Sternenlabor/Blinkenstar/firmware/README.md

When you flash the Blinkenstar make sure to set the FUSES.
See flash.sh for the full command.
