Sternenlabor/Blinkenstar/hardware/Blinkenstar/Blinkenstar-back.png

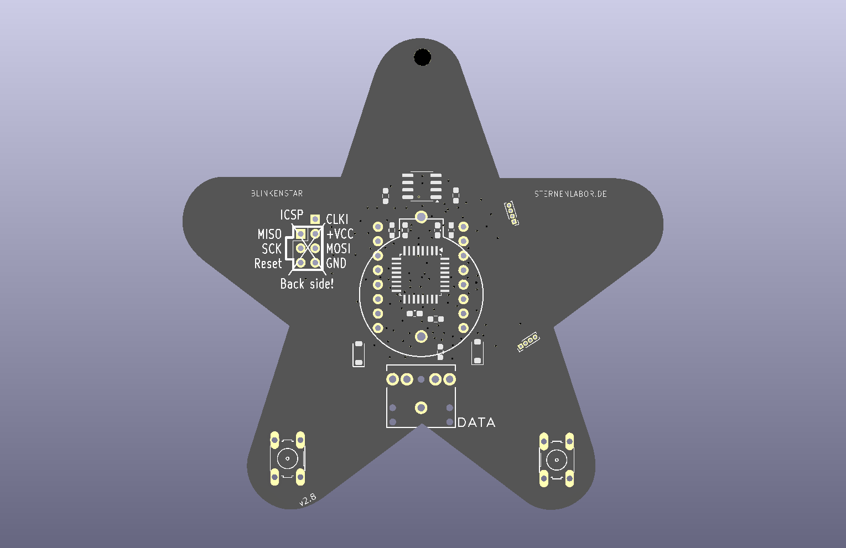
hardware/Blinkenstar/Blinkenstar-back.png
