Sternenlabor/Blinkenstar/hardware/Blinkenstar/Blinkenstar-front.png

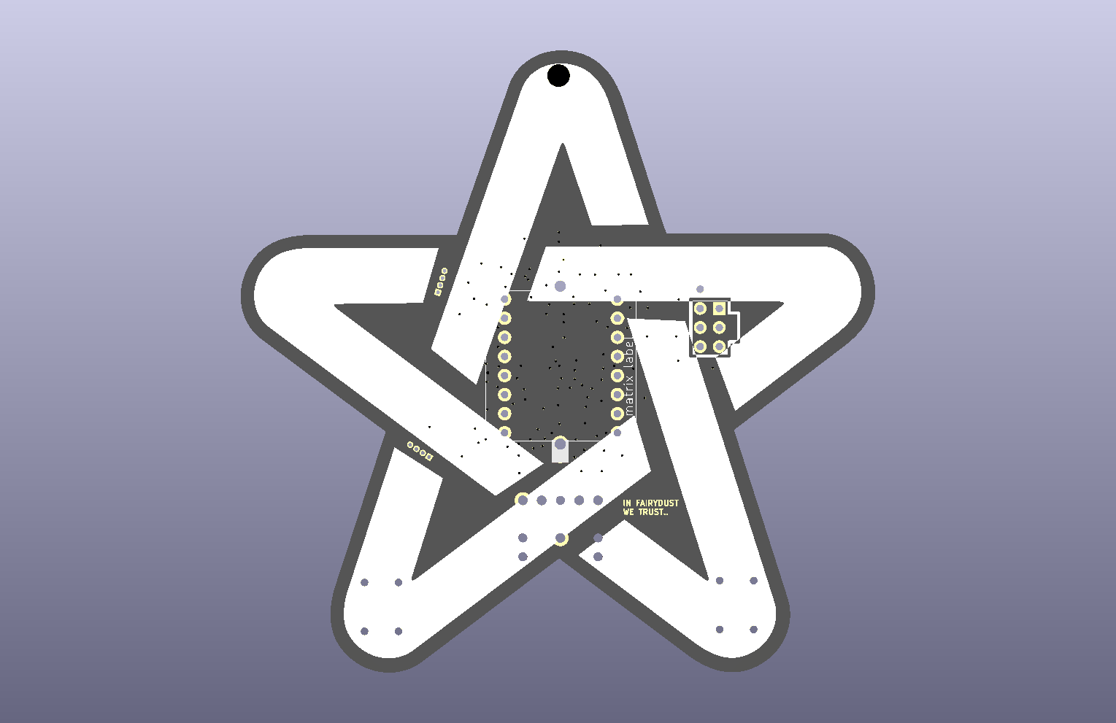
hardware/Blinkenstar/Blinkenstar-front.png
