Sternenlabor/Blinkenstar/hardware/Blinkenstar/parts/TEPT5700.step

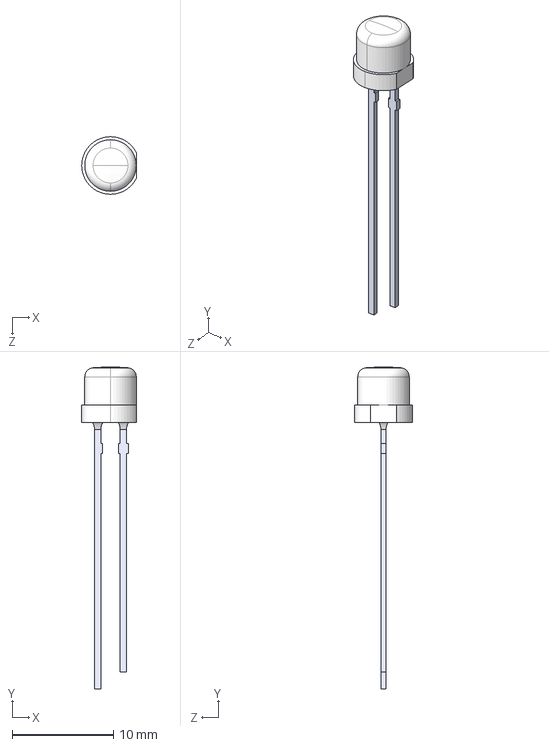
[picture p6: CAD file, 2025-06-20]
hardware/Blinkenstar/parts/TEPT5700.step
5.40 x 31.9 x 5.70 mm
