Sternenlabor/Blinkenstar/hardware/Blinkenstar/parts/B3F-1000.step

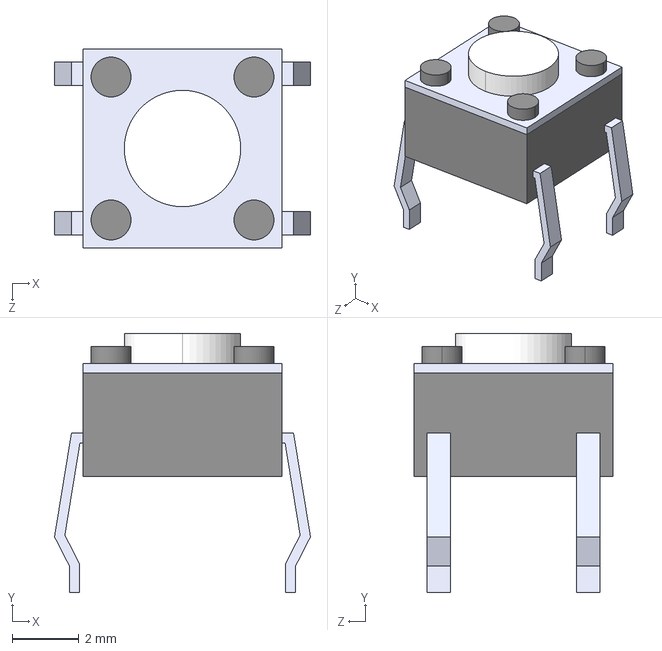
[picture p7: CAD file, 2025-06-01]
hardware/Blinkenstar/parts/B3F-1000.step
7.70 x 7.80 x 6.00 mm
