Sternenlabor/Blinkenstar/hardware/Blinkenstar/parts/M24C64-RMN6TP.STEP

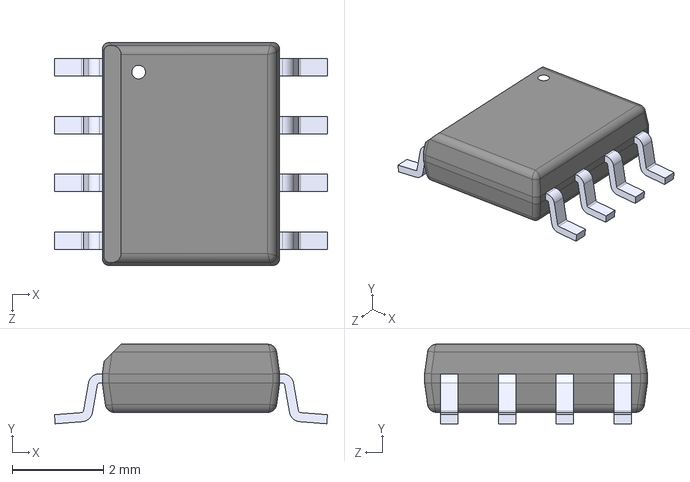
[picture p9: CAD file, 2025-03-28]
hardware/Blinkenstar/parts/M24C64-RMN6TP.STEP
6.00 x 1.75 x 4.90 mm
