Sternenlabor/Blinkenstar/hardware/Blinkenstar/parts/PJ-307--3DModel-STEP-510211.STEP

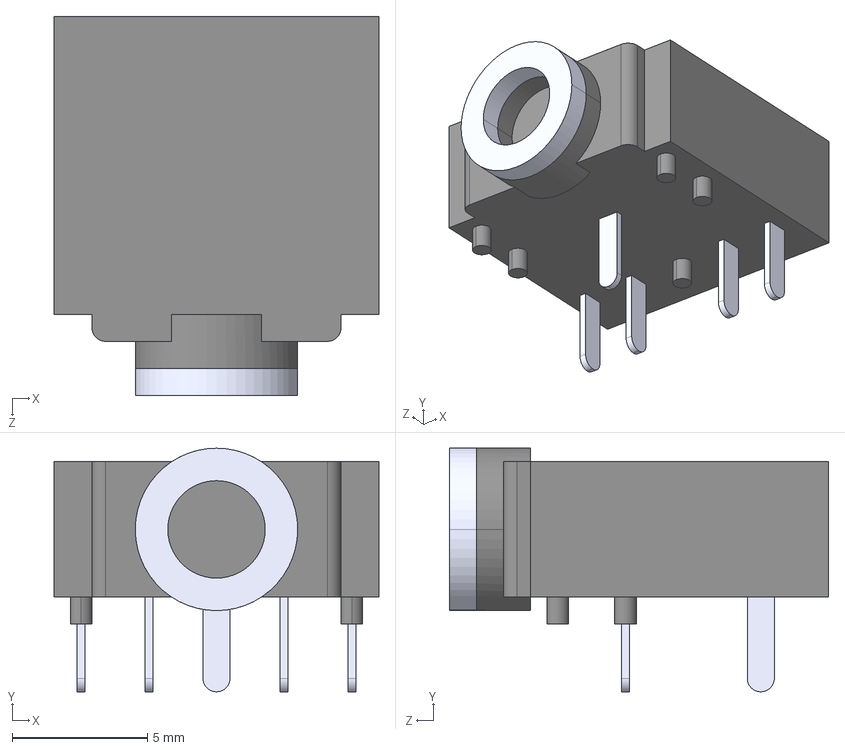
[picture p10: CAD file, 2025-03-28]
hardware/Blinkenstar/parts/PJ-307--3DModel-STEP-510211.STEP
12.0 x 9.00 x 14.0 mm
