Sternenlabor/Blinkenstar/hardware/Blinkenstar/parts/ATTINY88-AU.STEP

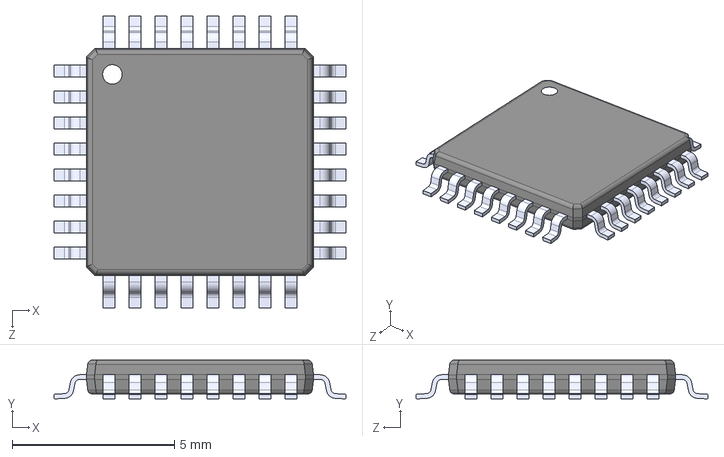
[picture p11: CAD file, 2025-03-28]
hardware/Blinkenstar/parts/ATTINY88-AU.STEP
9.00 x 1.20 x 9.00 mm
