Sternenlabor/Blinkenstar/hardware/Blinkenstar/parts/TA08-81GWA--3DModel-STEP-510211.STEP

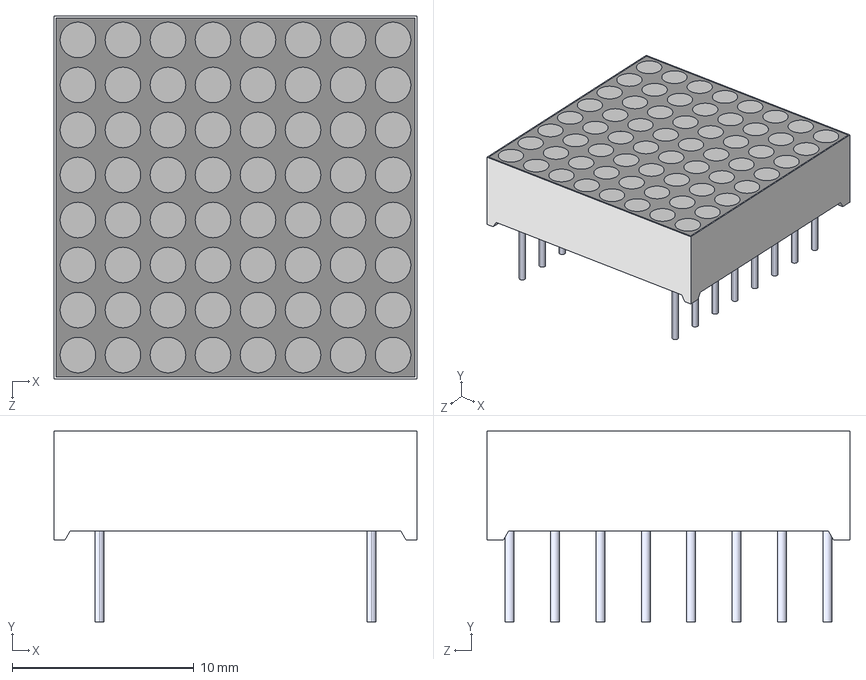
[picture p12: CAD file, 2025-03-28]
hardware/Blinkenstar/parts/TA08-81GWA--3DModel-STEP-510211.STEP
20.0 x 10.5 x 20.0 mm
