Sternenlabor/Blinkenstar/manual/manual.generated.pdf

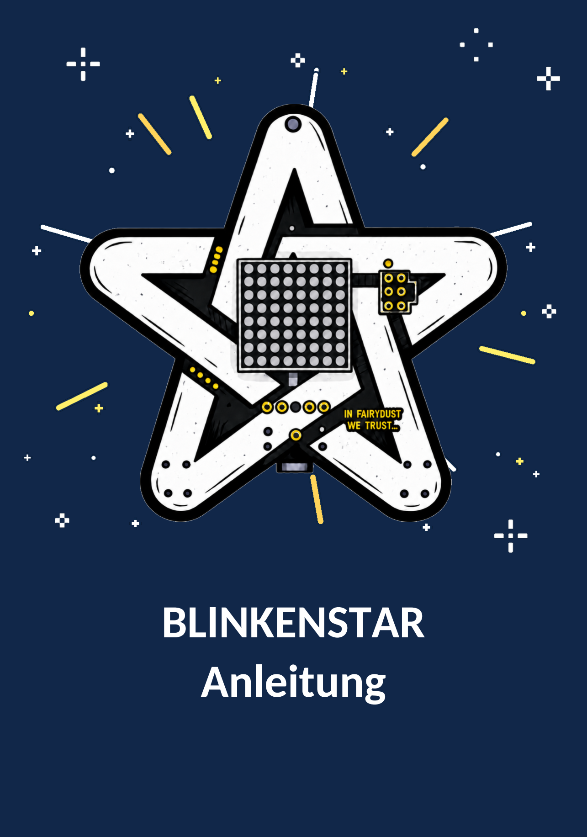
[picture p13: page 1]

# BLINKENSTAR Anleitung

## SICHERHEITSHINWEISE

Nach dem Löten musst du dir deine Hände gründlich mit Seife waschen. Lötzinn ist nicht gesund und sollte nicht in die Nähe von Essen kommen. Essen und Trinken solltest du beim Löten vermeiden!

## LÖTEN LERNEN

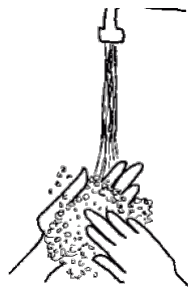
[picture p14: figure]

Zum Löten benötigst du einen Lötkolben, der auf eine Temperatur zwischen 310°C und 350°C eingestellt werden muss. Bei dieser Temperatur wird das Lötzinn flüssig und verbindet dein Bauteil mit der Platine. Bei so viel Hitze kannst du dich und andere schnell verletzen. Stelle deswegen den Lötkolben immer in die Halterung, wenn du ihn gerade nicht benötigst.

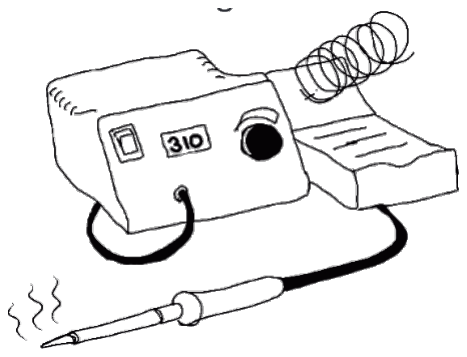
[picture p15: figure]

## BEDRAHTETE BAUTEILE LÖTEN

Stecke das Bauteil an der passenden Stelle durch die Löcher in der Platine. Das Bauteil muss auf der bedruckten Seite aufliegen. Sollte das Bauteil rausfallen, biege die Beinchen leicht zur Seite. Nun lötest du nacheinander die Beinchen des Bauteils. Heize dazu gleichzeitig das Beinchen des Bauteils und die Platine auf. Führe dann seitlich etwas Lötzinn hinzu, bis sich ein kleiner Hügel Lötzinn bildet, der das Loch vollständig bedeckt.

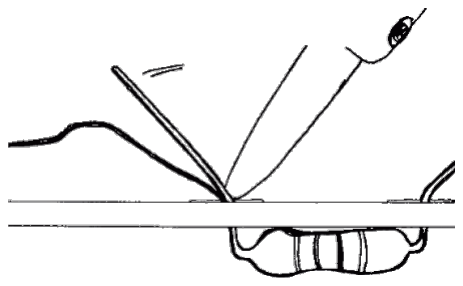
[picture p16: figure]

Die Lötstelle sollte ungefähr wie auf dem folgenden Bild aussehen. Überflüssiges Lötzinn kannst du mit der Lötspitze an dem Draht- beinchen nach oben ziehen. Mit etwas Übung werden deine Lötstellen immer besser!

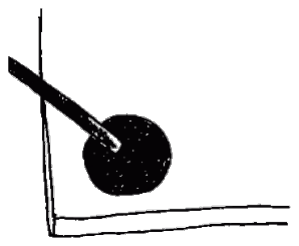
[picture p17: figure]
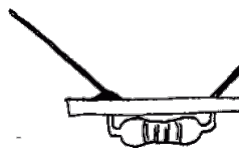
[picture p18: figure]

## SMD BAUTEILE LÖTEN

SMD Bauteile sind Bauteile, die du auf der Oberfläche der Platine an so genannte "Lötpads" anlötest. Lötpads sind Flächen auf der Platine, die Lötzinn annehmen. Um ein SMD Bauteil anzulöten, erhitzt du die Platine zunächst an den quadratischen oder rechteckigen Flächen, die wir "Pad" nennen. Gib auf eine Seite eines Pad-Paares etwas Lötzinn bis sich ein kleiner Berg Lötzinn gebildet hat. Es ist wichtig, dass immer nur ein Pad mit Lötzinn bedeckt wird, sonst wird das Löten sehr schwierig!

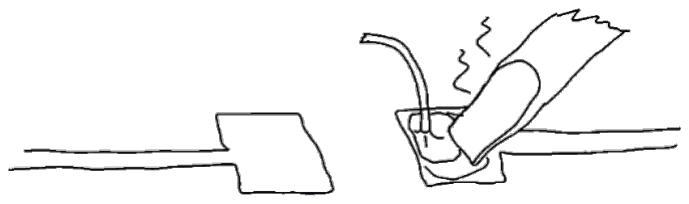
[picture p19: figure]

Halte nun den Lötkolben an das mit Lot bedeckte Pad und greife das Bauteil gleichzeitig mit einer Pinzette. Schiebe das Bauteil mit einer Seite in das flüssige Lot, so dass es mittig zwischen den beiden Pads sitzt. Entferne nun den Lötkolben und halte das Bauteil solange fest, bis das Lötzinn wieder fest geworden ist.

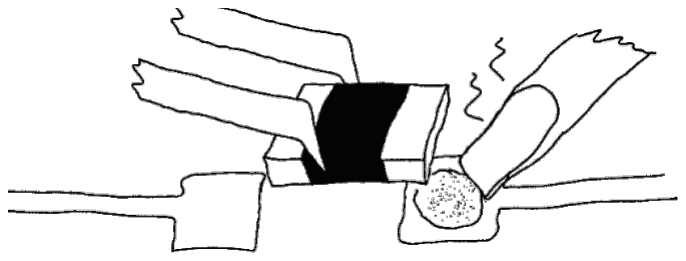
[picture p20: figure]

Um die andere Seite des Bauteils festzulöten, erhitzt du das Pad und die noch fehlende Seite des Bauteils. Während du die Stelle mit dem Lötkolben erhitzt, führst du solange etwas Lötzinn hinzu, bis die Lötstelle wie auf dem Bild aussieht. Versuche das Bauteil zügig zu löten, damit die gegenüberliegende Lötstelle nicht wieder warm wird. Sehr hohe Temperaturen können das Bauteil beschädigen.

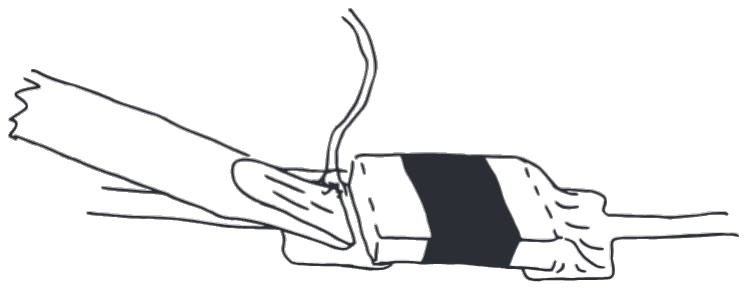
[picture p21: figure]

Deine Lötstellen sollten ungefähr so aussehen, wie auf dem Bild. Die Pins der SMD Bauteile sollten seitlich komplett mit Lötzinn benetzt sein. Wenn du die Platine nach dem Löten umdrehst, dürfen die Bauteile nicht mehr abfallen.

## SMD BAUTEILE MIT VIELEN KONTAKTEN EINFACH LÖTEN

Es gibt SMD Bauteile mit sehr vielen Kontakten, die wir häufig auch Beinchen oder Pin nennen. Daher haben die Bauteile an der dafür vorgesehenen Stelle auf der Platine auch sehr viele Pads. Mit der richtigen Technik ist das allerdings für dich sicher kein Problem!

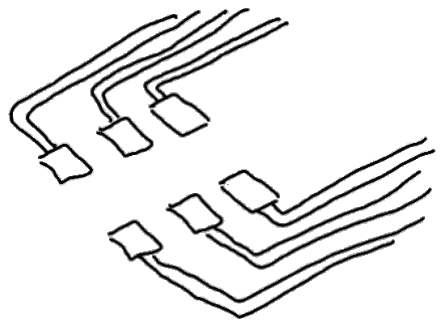
[picture p22: figure]

Zuerst suchst du dir ein Pad an einer Ecke des Bauteils aus und führst etwas Lötzinn hinzu, bis ein kleiner Berg entsteht. Das Prinzip kennst du schon von den SMD Bauteilen mit nur zwei Kontakten.

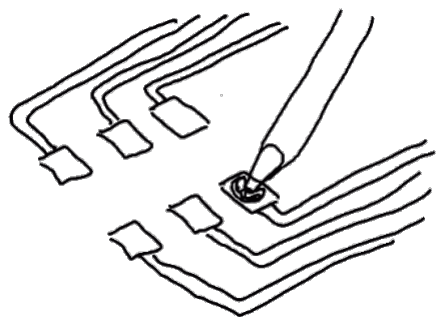
[picture p23: figure]

Anschliessend setzt du das Bauteil mit einer Pinzette auf die Pads und richtest alle Beinchen so aus, dass sie auf den Pads aufliegen. Halte das Bauteil mit der Pinzette die ganze Zeit gut fest, damit es nicht wegrutschen kann. Jedes Bauteil hat eine Markierung, z.B. einen Punkt, oder eine Kerbe an der Seite, um dir die Ausrichtung zu zeigen! Wenn du Bauteile verdreht auflötest funktionieren sie nicht!

Nun erhitzt du den Pin mit dem Lötzinn, bis das Lötzinn
geschmolzen ist und den Pin umfließt. Nimm dann den Lötkolben weg und lasse das Lötzinn wieder kalt werden. Wenn das Bauteil leicht verdreht ist, erhitze den Pin wieder und drehe das Bauteil mit der Pinzette.
Jetzt lötest du den diagonal gegenüberliegenden Pin an, indem du Pin und Lötpad erhitzt und etwas Lötzinn hinzufügst. Mache dann mit den noch nicht gelöteten Pins weiter.

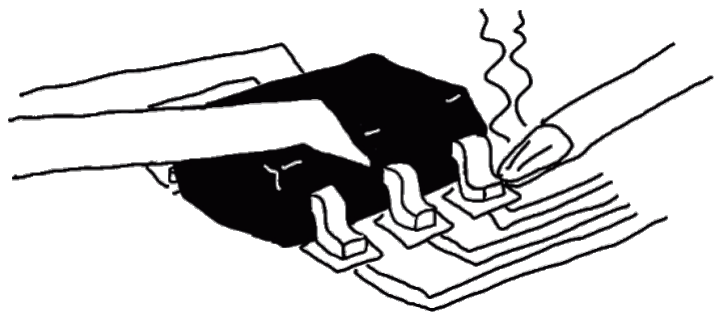
[picture p24: figure]

## BLINKENSTAR RICHTIG LÖTEN: DER MIKROCONTROLLER

### 1 Drehe die Platine so, dass sie dem Bild entspricht. Wenn der

Mikrocontroller schon verlötet ist, mache einfach mit Schritt 2 weiter. Ansonsten lötest du den Mikrocontroller U2 auf die Platine. Diesen findest du in einer separaten Verpackung in deinem Bausatz. Beim Löten folgst du am besten der Lötanleitung für Bauteile mit vielen Kontakten.

Achte bitte besonders auf die Ausrichtung des Mikrocontrollers anhand der kreisförmigen Markierung auf Platine und Bauteil! Beginne zuerst mit einem einzigen Beinchen und richte den Mikrocontroller richtig aus, so dass alle Beinchen auf ihrem Pad sitzen. Löte dann das Beinchen gegenüber des bereits angelöteten Beinchens an. So wird dein Blinkenstar sicher funktionieren!
2 Das zweite Bauteil ist der EEPROM mit der Bezeichnung U3.

Ist dieser schon verlötet, mache einfach mit Schritt 3 weiter. Auch dieses Bauteil lötest du wie das vorherige Bauteil zuerst mit einem Beinchen an und richtest es dann aus. Achte auch hier wieder auf die kreisförmige Markierung die die richtige Richtung vorgibt! Nachdem du den gegenüber liegenden Pin angelötet hast, kannst du die anderen Pins festlöten.

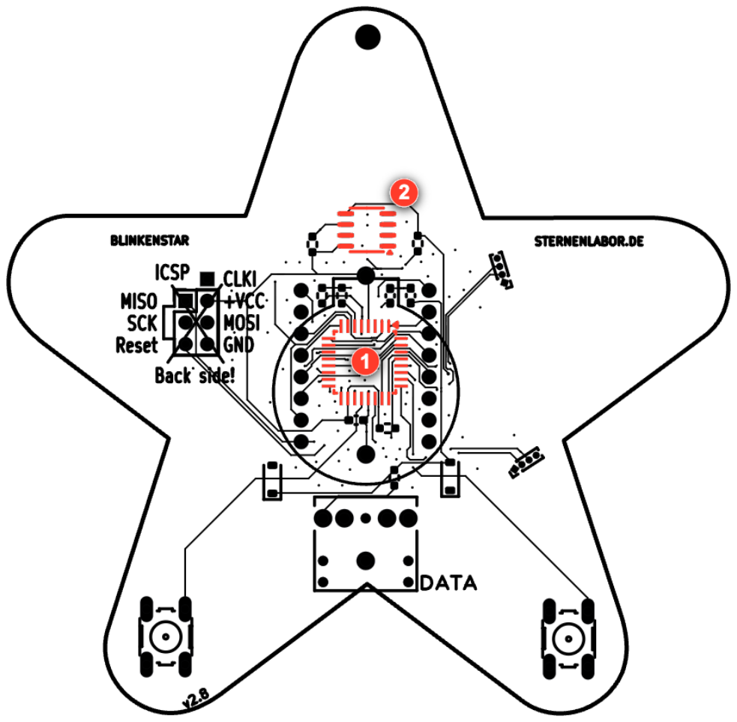
[picture p25: page 9]

## BLINKENSTAR RICHTIG LÖTEN: DIE KLEINEN BAUTEILE

### 3 Löte nun nacheinander die restlichen kleinen Bauteile

auf die Platine. Sind die Bauteile schon verlötet, mache mit Schritt 4 weiter. Die Position der Bauteile findest du auf der abgebildeten Platine.

Achte darauf, dass du die Bauteile an der richtigen Stelle platzierst. Es ist wichtig, dass die SMD Bauteile immer mittig zwischen den beiden Pads sitzen. Wenn du die Platine wie abgebildet hinlegst, sind alle Bauteile waagerecht angeordnet.

! Achtung! Die Dioden D1 und D2 müssen dieselbe

Richtung haben! Die Dioden haben dazu eine Markierung auf ihrem Gehäuse, welche du auch auf der Platine sehen kannst!

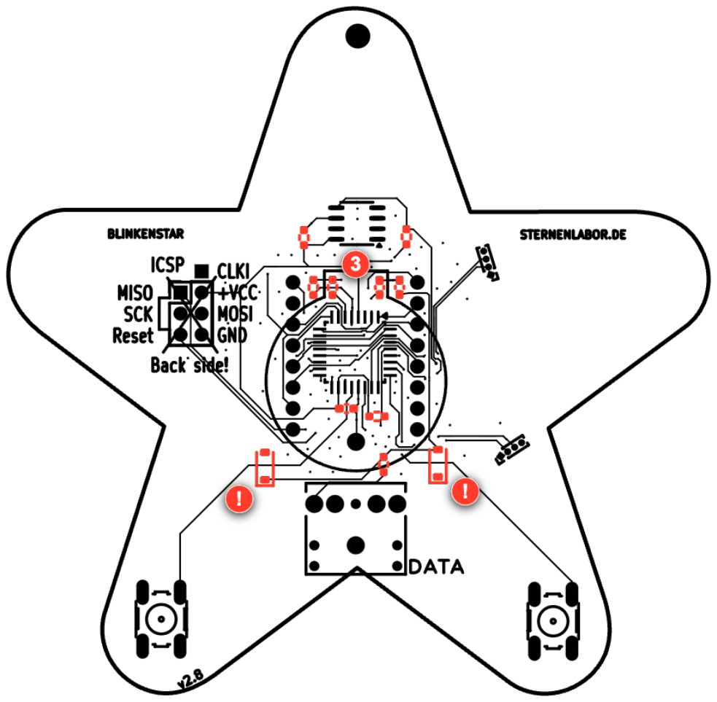
[picture p26: page 11]

## BLINKENSTAR RICHTIG LÖTEN: DAS MATRIX DISPLAY

### 4 Drehe die Platine auf die Seite, auf der sich noch keine

Bauteile befinden. Die Beinchen bzw. Kontakte der Bauteile werden auf der Seite festgelötet, auf der sich bereits die kleineren SMD Bauteile befinden. Das nächste Bauteil ist das Matrix Display. Stecke es auf der Seite mit dem weißen Stern durch die Löcher. Verlötet wird es auf der anderen Seite, auf der sich die SMD Bauteile befinden. Versuche dabei die Beinchen nicht zu verbiegen. Ganz wichtig: der Pin 1 des Displays muss an der Pin 1 Markierung durch das Loch gesteckt werden! Gibt es keine Pin 1 Markierung, achte daruf, dass der Text an der Seite des Displays nach rechts zeigt. Die einzelnen Pins lötest du dann nach der Anleitung nacheinander an die Platine. Lasse dabei die einzelnen Pins nicht zu warm werden.
! Achtung! Achte unbedingt auf die "Pin 1" Markierung des

Displays! Gibt es keine Markierung, achte darauf, dass der Aufdruck auf der rechten Seite ist. Das Display muss von der Seite eingesetzt werden, auf der noch keine Bauteile sind!

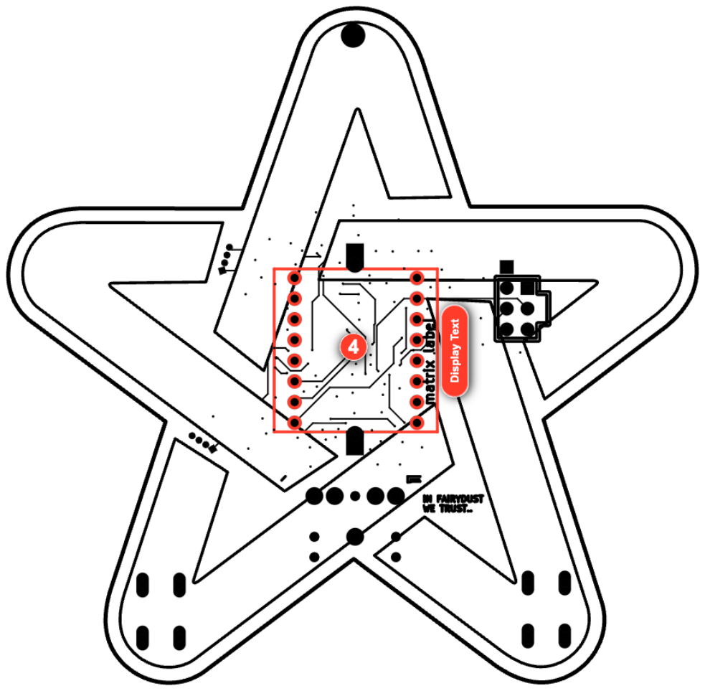
[picture p27: page 13]

## BLINKENSTAR RICHTIG LÖTEN: DIE BEDRAHTETEN BAUTEILE

### 5 Stecke den Batteriehalter über den Mikrocontroller in die

dafür vorgesehenen Löcher. Verlöte die Beinchen auf der Seite mit dem weißen Stern ganz knapp am Matrix Display.

### 6 Nun lötest du noch die beiden Taster und die Audio-Buchse

an. Stecke die Pins von der Seite mit den SMD Bauteilen durch die Platine. Verlöte sie anschließend auf der Seite mit dem weißen Stern. Sollten die Bauteile beim Löten herunterfallen, lege einfach einen Gegenstand unter.

! Nur wenn die Lötstellen in Ordnung sind, wird dein

Blinkenstar richtig funktionieren. Prüfe daher nach dem Löten aller Teile, ob diese fest mit der Platine verbunden sind.

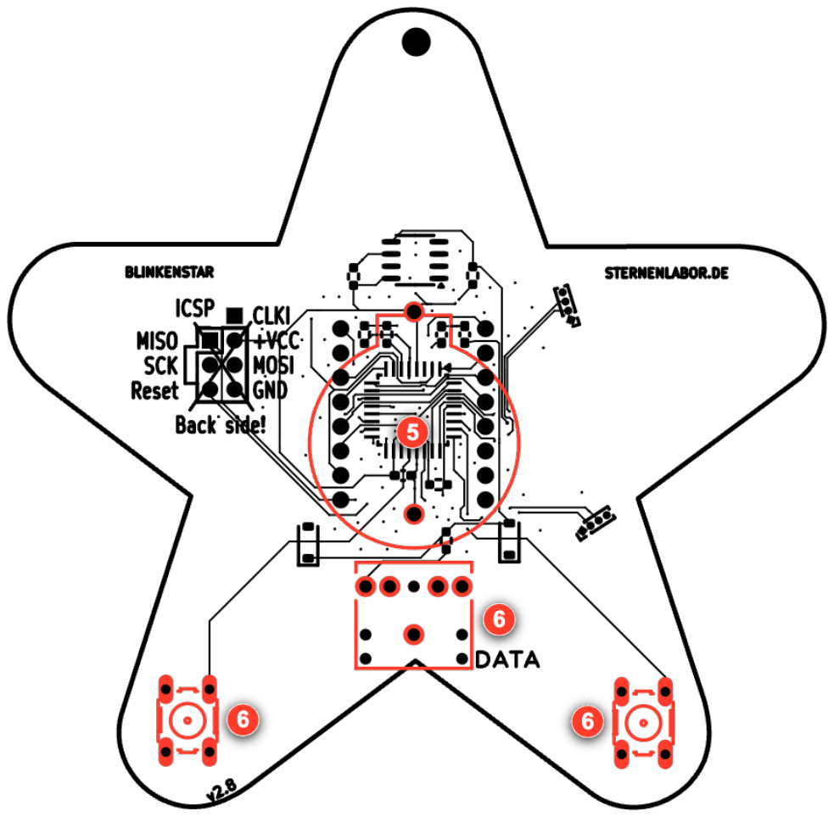
[picture p28: page 15]

## BLINKENSTAR IN BETRIEB NEHMEN

### 7 Packe die Batterie aus und setze sie richtig in den

Batteriehalter. Ein kleines Plus zeigt dir, wie die Batterie in den Halter muss. Dein Blinkenstar sollte jetzt schon etwas auf dem Display anzeigen. Wenn nicht, dann prüfe, ob du alle Teile richtig gelötet hast und diese die richtige Richtung haben.

### 8 Durch dieses Loch kannst du die Kordel fädeln, die deinem

Bausatz beiliegt. So kannst du deinen Blinkenstar um den Hals hängen um ihn z.B. als Namensschild zu benutzen.

### 9 Mit dem beiliegenden Audio-Adapter kannst du deine

Blinkenstar mit neuen Texten und Animationen bespielen. Stecke den Adapter in die Audio-Buchse an deinem Smartphone oder Computer und stelle die Lautstärke auf das Maximum. Gehe auf
https://blinkenstar.sternenlabor.de/ und folge den Anweisungen auf der Webseite. Sollte die Übertragung nicht funktionieren, vergewissere dich, dass du die Lautstärke auf das Maximum gestellt hast, alle Kabel verbunden sind und keine andere Musik läuft.

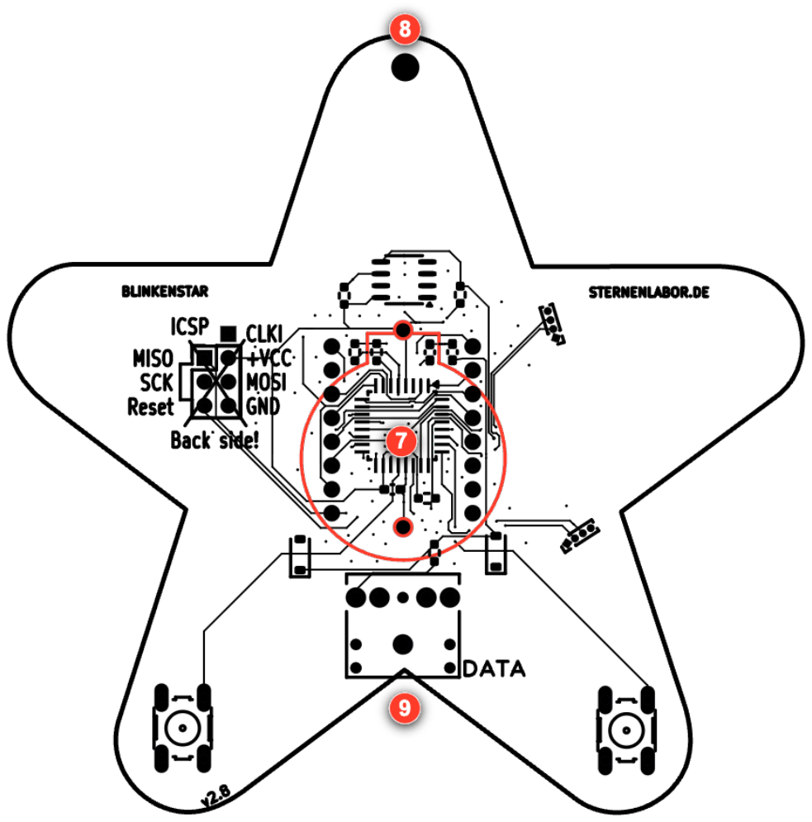
[picture p29: page 17]

## ÜBER BLINKENSTAR

Deinen Blinkenstar kannst du jederzeit mit neuen Inhalten bespielen. Gehe dazu einfach mit deinem Smartphone oder Computer auf https://blinkenstar.sternenlabor.de/ und befolge die Anweisungen auf der Webseite. Den Programmcode sowie andere Dateien der Blinkenstar findest du frei zugänglich unter https://github.com/Sternenlabor/Blinkenstar.

Die erste Version des Blinkenstar Bausatz wurde in vielen Stunden von freiwilligen Helfern des Chaos Computer Club Düsseldorf e.V. und des shack e.V. mit viel Liebe zum Detail gebaut. Du kannst die beiden gemeinnützigen Vereine gerne mit einer kleinen Spende unterstützen!

Die Bilder der Lötanleitung sind aus den Comics "Soldering is easy" von mightyohm.com und "SMT soldering - it's easier than you think" von siliconfarmers.com entnommen und unter einer Creative Commons Attribution Share-Alike Lizenz lizensiert. Diese Anleitung und Blinkenstar Bilder sind ebenfalls unter dieser Lizenz lizensiert. Die Blinkenstar Platine ist unter der CERN Open-Hardware License Version 1.2 lizensiert, die Firmware steht unter der Lesser General Public License Version 3.0 (LGPL
V. 3.0) zur Verfügung.

Dieser Bausatz wurde von Sebastian 'muzy' Muszytowski und Florian 'overflo' Bittner realisiert und mit freundlicher Unterstützung des Chaos Computer Club e.V. im Rahmen des "Chaos macht Schule" Projekt finanziell gefördert. Besonderer Dank gelten derf, marudor, rashfael, metachris und Chris Veigl sowie tele und linx.
