Sternenlabor/Blinkenstar/manual/assets/manual-elements/page-001-image-005-blinkenstar.png

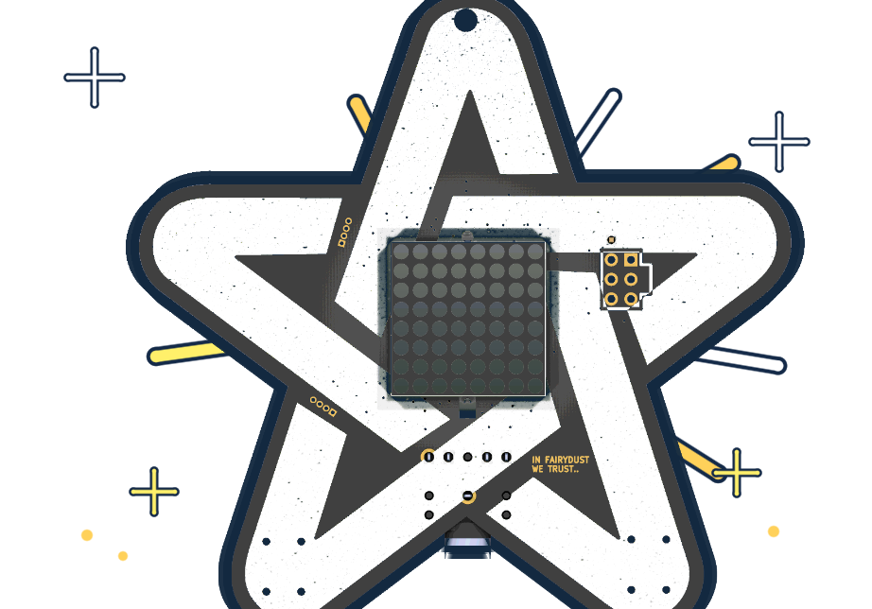
manual/assets/manual-elements/page-001-image-005-blinkenstar.png
