Sternenlabor/Blinkenstar/manual/assets/manual-elements/page-001-image-005.png

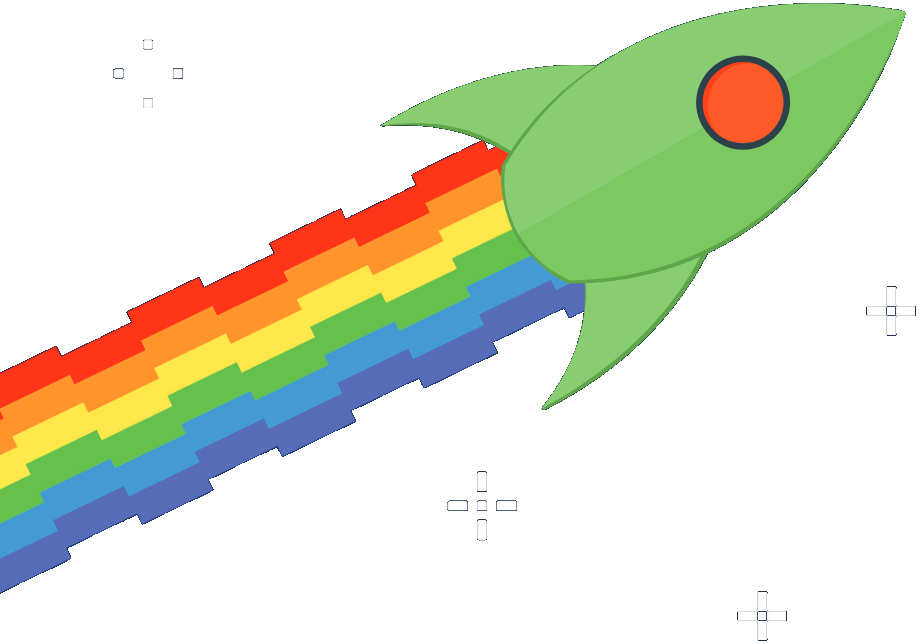
manual/assets/manual-elements/page-001-image-005.png
