Sternenlabor/Blinkenstar/manual/Blinkenstar-2.png

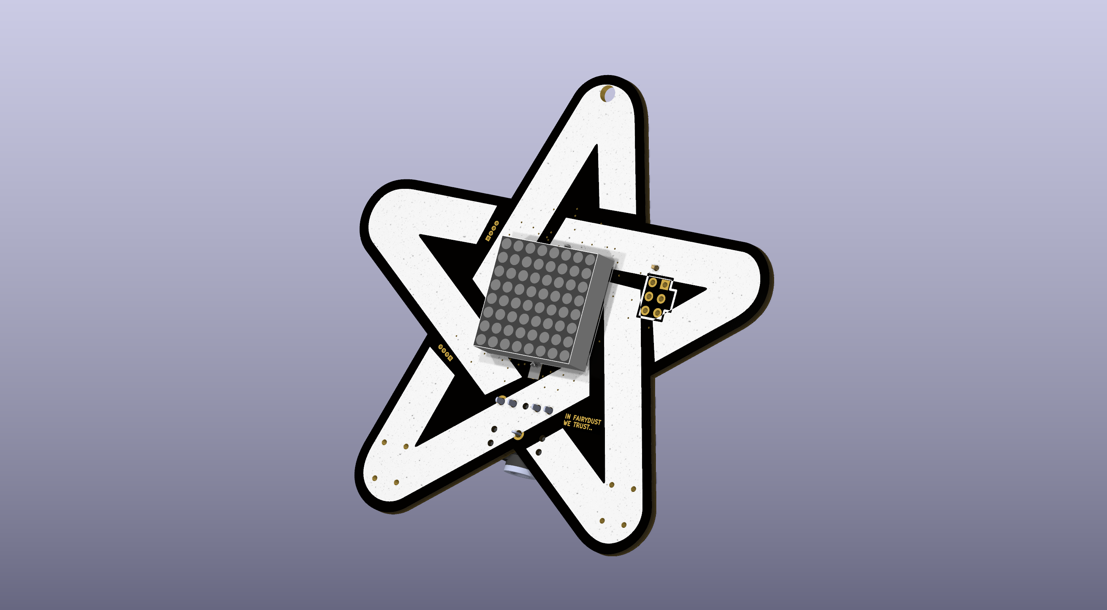
manual/Blinkenstar-2.png
