Sternenlabor/Blinkenstar/manual/Blinkenstar.png

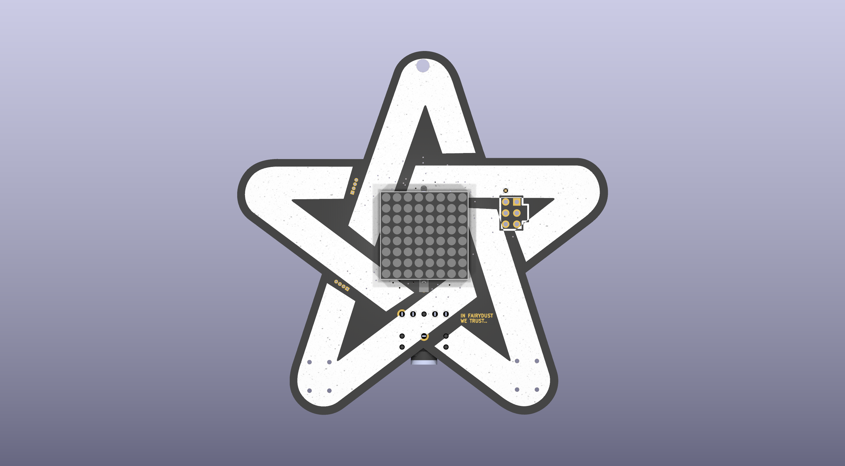
manual/Blinkenstar.png
