Sternenlabor/Blinkenstar/manual/Blinkenstar_Comic_Style.png

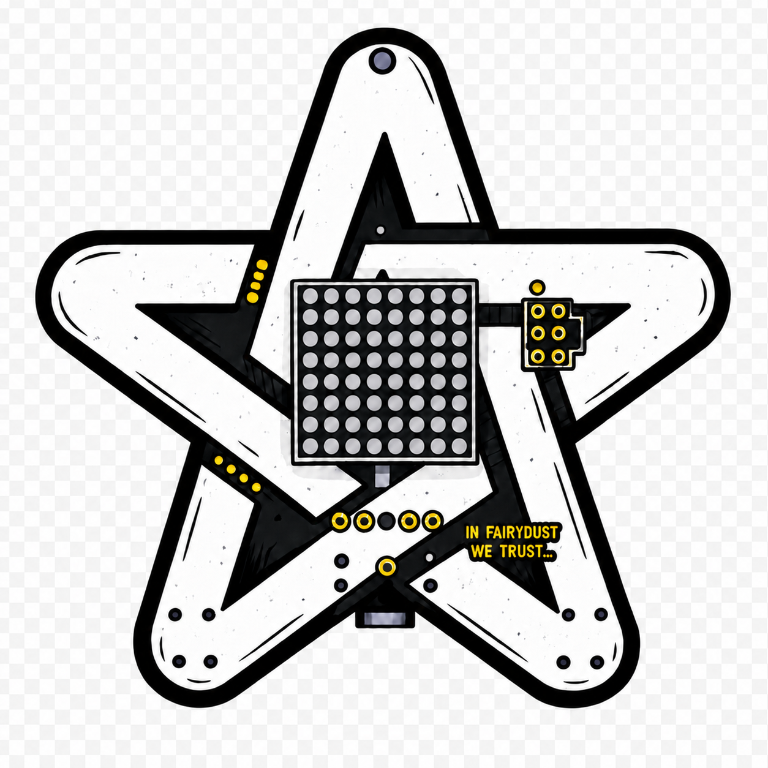
manual/Blinkenstar_Comic_Style.png
