Sternenlabor/Blinkenstar/hardware/Blinkenstar/Blinkenstar.pdf

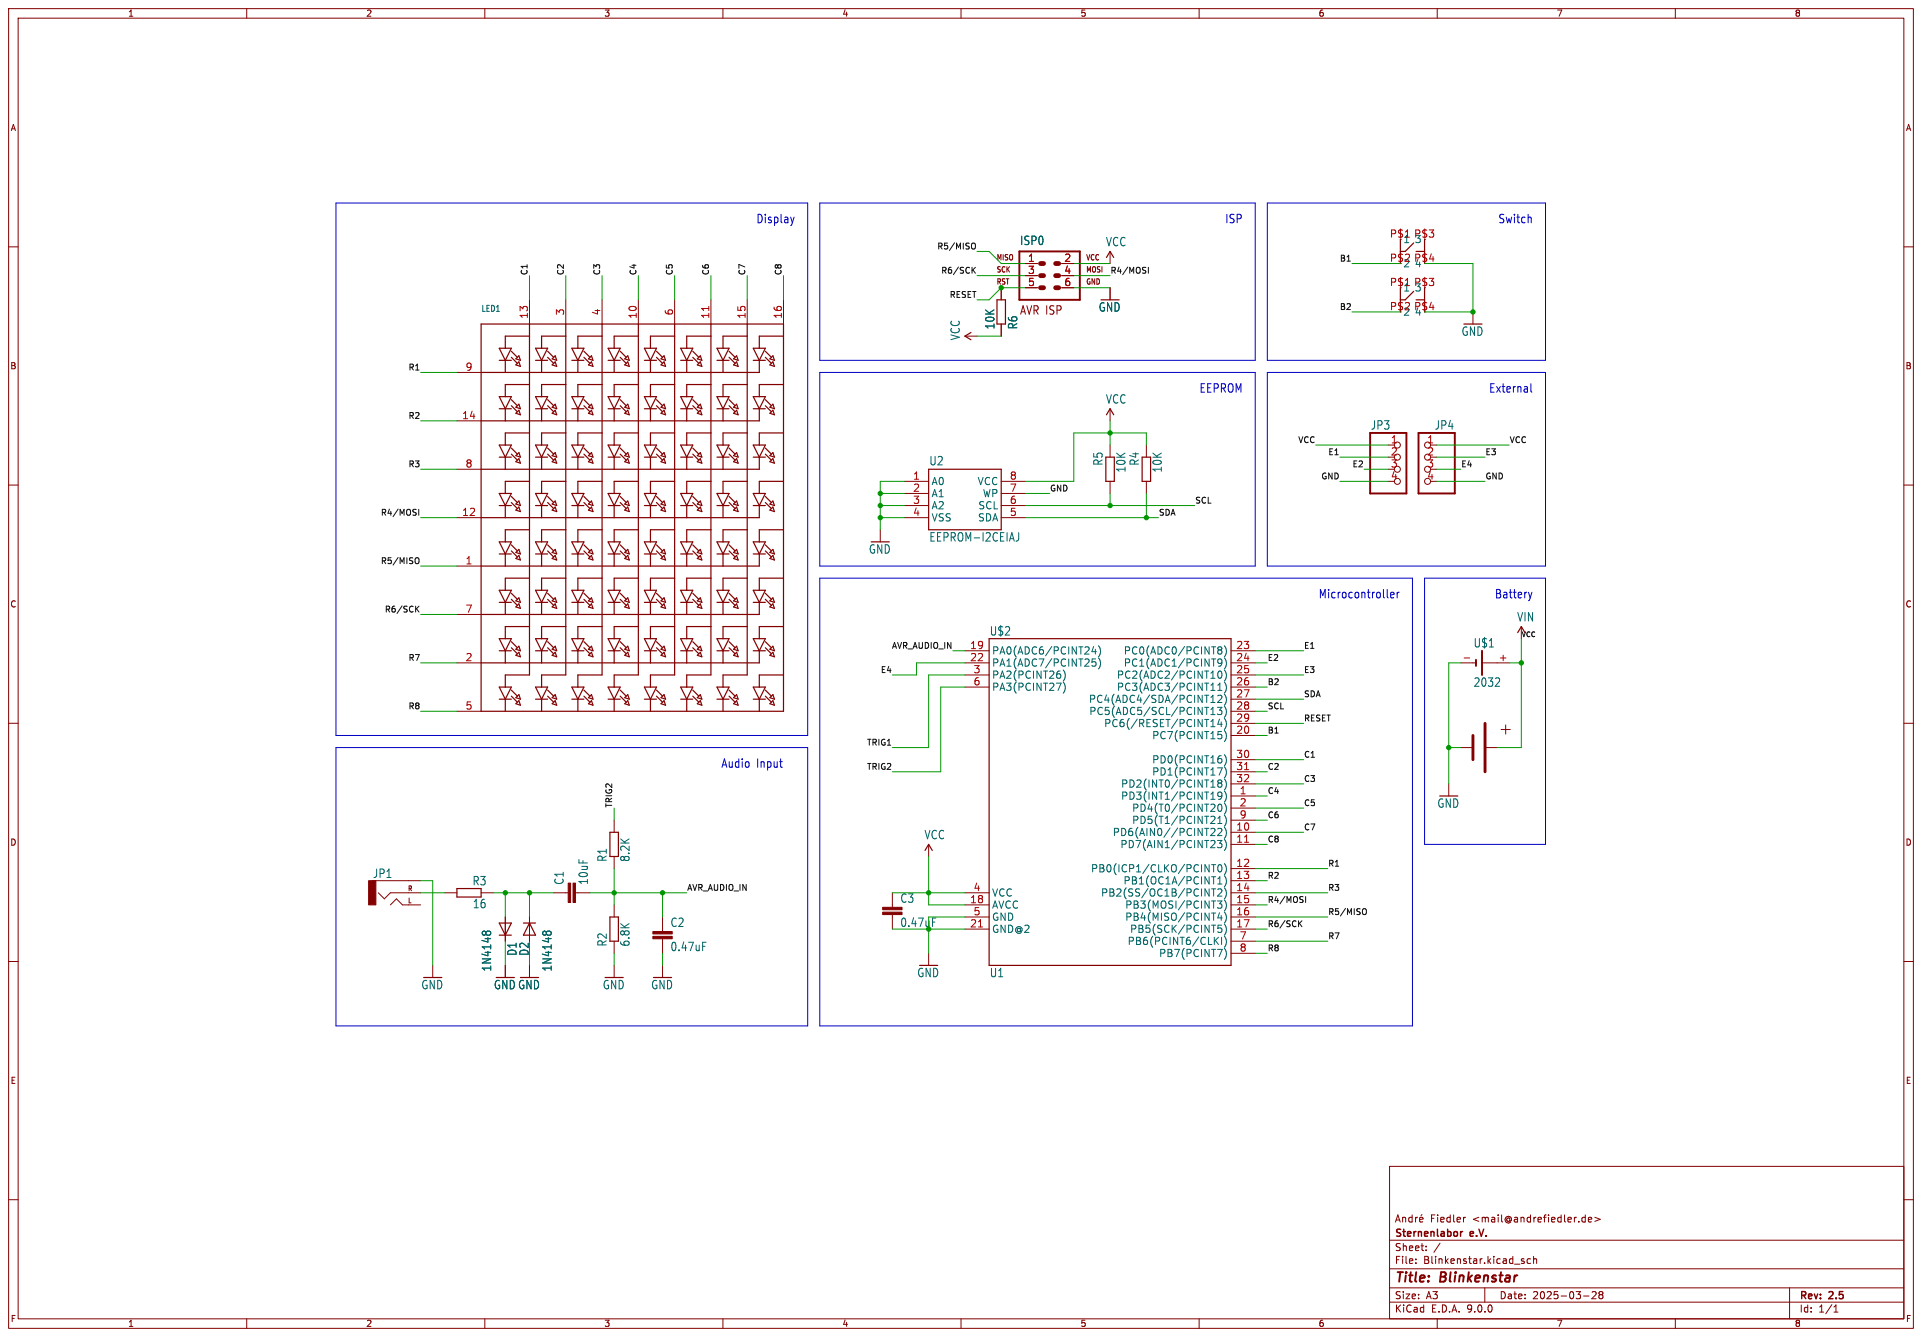
[picture p60: page 1]
