Sternenlabor/Blinkenstar/manual/Blinkenstar.pdf

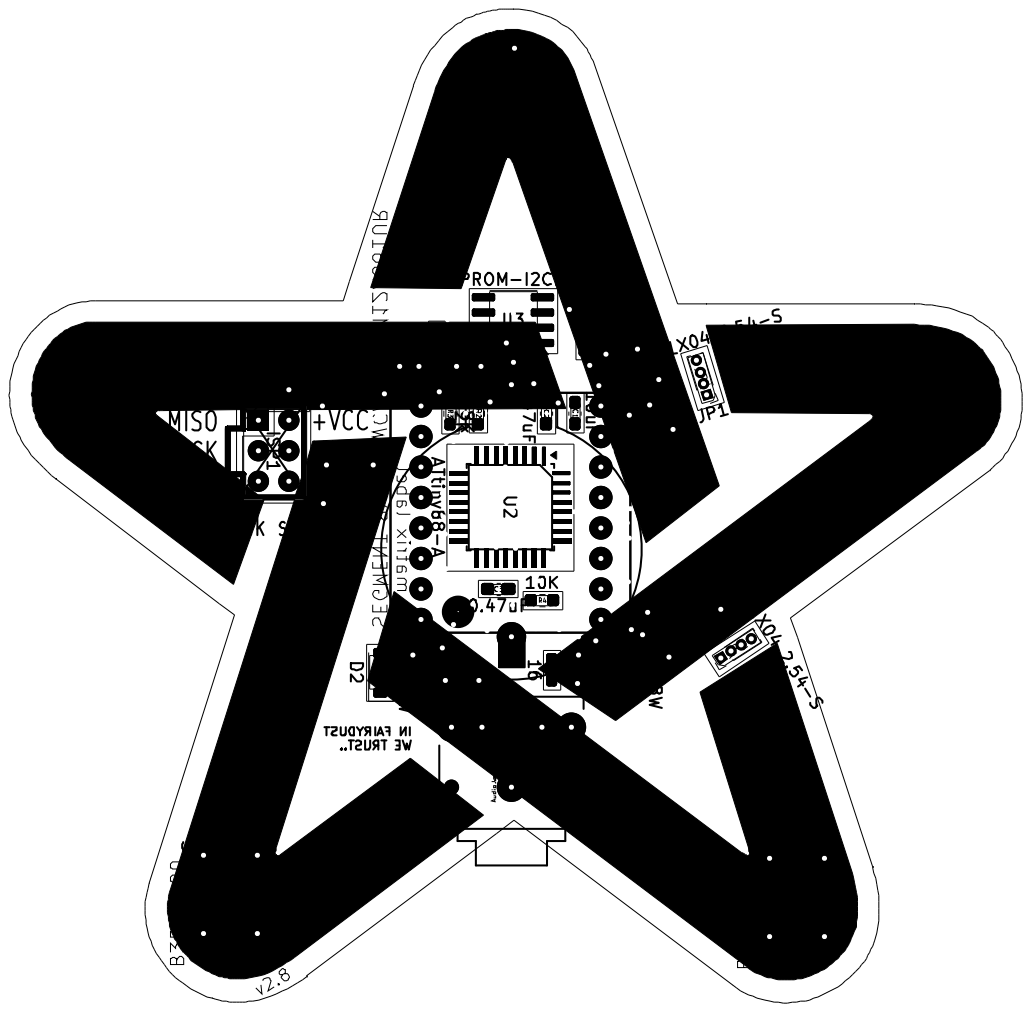
[picture p61: page 1]
