Sternenlabor/Blinkenstar/hardware/Blinkenstar/Blinkenstar.kicad_pcb

## KiCad design hardware/Blinkenstar/Blinkenstar.kicad_pcb (2026-05-14)

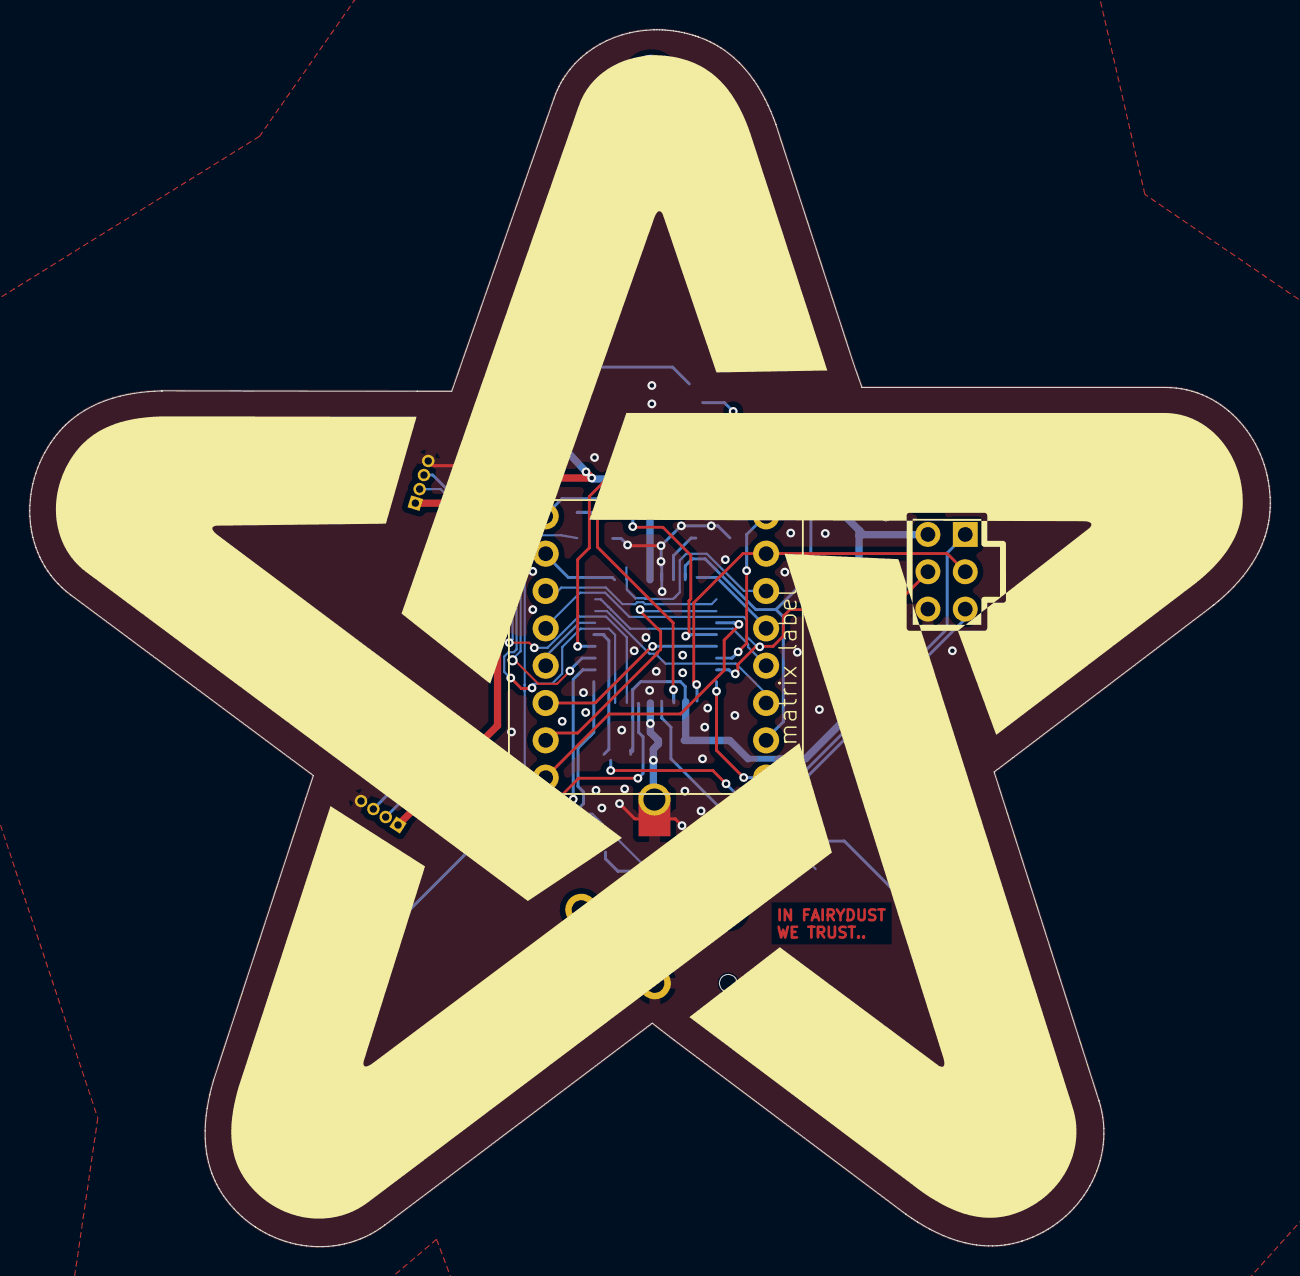
[picture p62: board Blinkenstar.kicad_pcb from above]

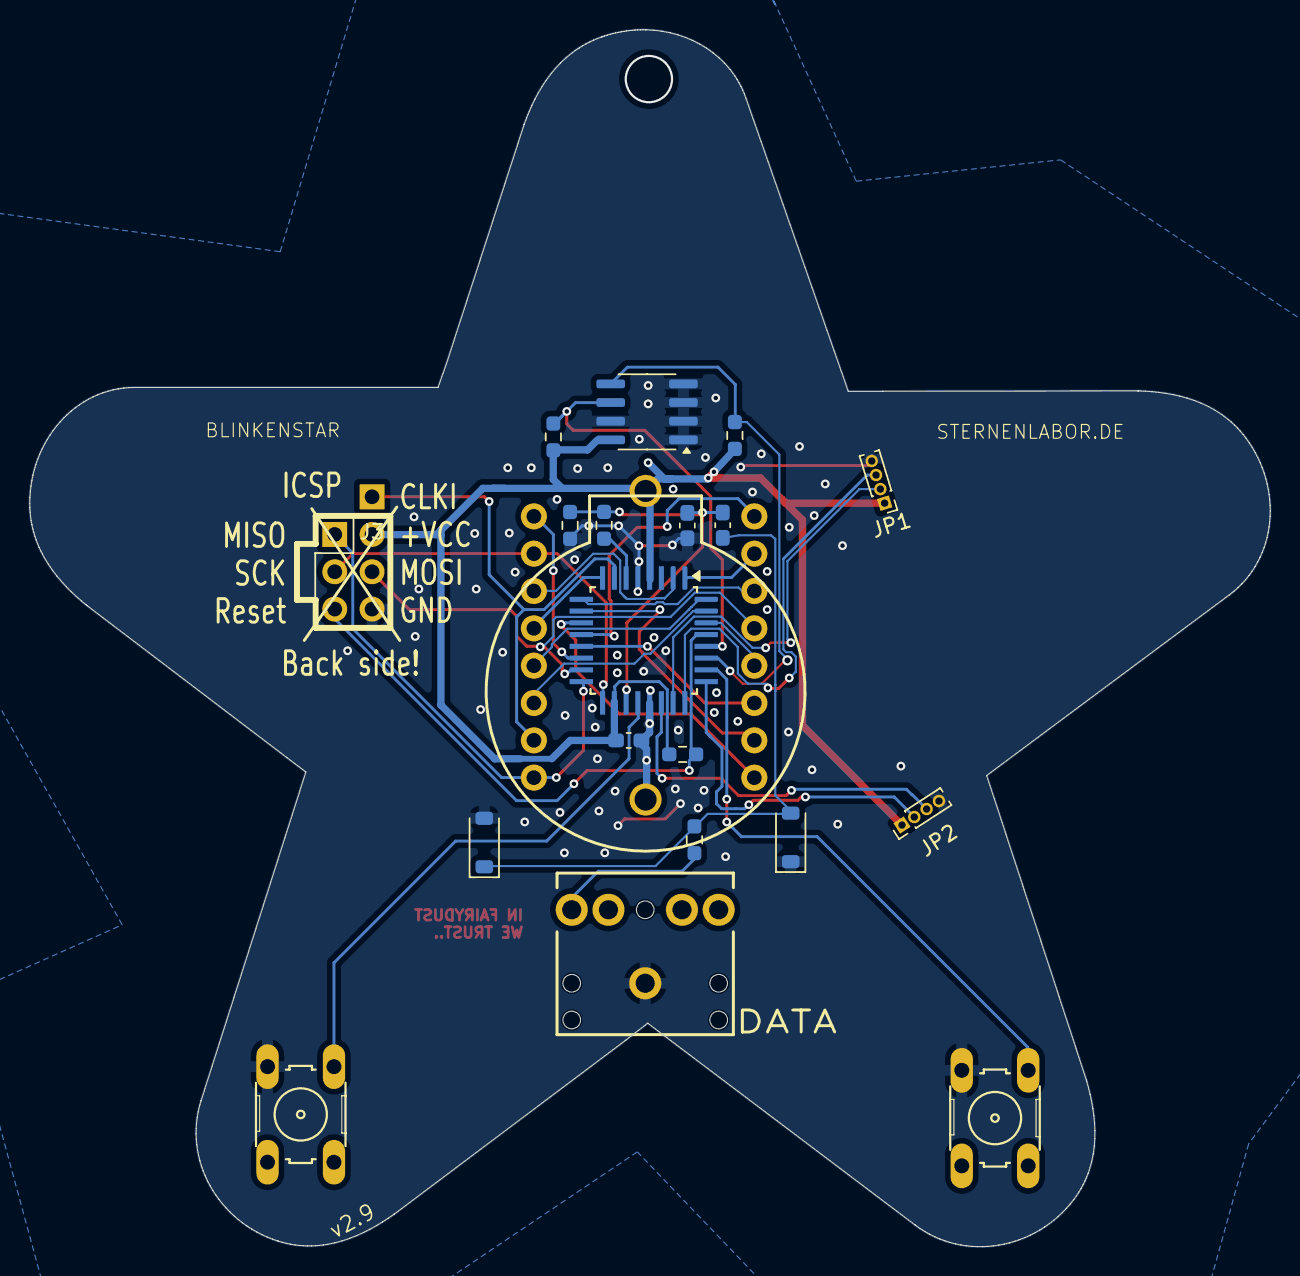
[picture p63: board Blinkenstar.kicad_pcb from below]

Board: 2 copper layers, 84.4 x 82.8 mm, 22 parts (21 on the bottom side), 31 nets.

Parts:
BT1: Battery_Cell; CR2032PAC_ELECTRODRAGON
C1: 10uF; C_0603_1608Metric_Pad1.08x0.95mm_HandSolder
C2, C3: 0.47uF; C_0603_1608Metric_Pad1.08x0.95mm_HandSolder
D1, D2: 1N4148W; D_SOD-123
ISP1: AVR-ISP-6VERT; PinHeader_2x03_P2.54mm_Vertical
J1: AudioJack2_Ground; AUDIO-JACK
J3: CLKI; PinHeader_1x01_P2.54mm_Vertical
JP1, JP2: PINHD-1X04_2.54-S; PinHeader_1x04_P1.00mm_Vertical
LED1: SEGMENT_8X8_ROWCATHODEM12A881UR; SEGMENT_BL-M12A883
R1: 16; R_0603_1608Metric_Pad0.98x0.95mm_HandSolder
R2: 8.2K; R_0603_1608Metric_Pad0.98x0.95mm_HandSolder
R3: 6.8K; R_0603_1608Metric_Pad0.98x0.95mm_HandSolder
R4, R5, R6: 10K; R_0603_1608Metric_Pad0.98x0.95mm_HandSolder
S1, S2: B3F-1000; B3F-10XX
U2: ATtiny88-A; TQFP-32_7x7mm_P0.8mm
U3: EEPROM-I2CEIAJ; SOIC-8_3.9x4.9mm_P1.27mm

Connections:
/AVR_AUDIO_IN: C1.2, C2.1, R2.1, R3.2, U2.19 (PA0)
/B1: S1.1, U2.20 (PC7)
/B2: S2.1, U2.26 (PC3)
/C1: LED1.13 (A1), U2.30 (PD0)
/C2: LED1.3 (A2), U2.31 (PD1)
/C3: LED1.4 (A3), U2.32 (PD2)
/C4: LED1.10 (A4), U2.1 (PD3)
/C5: LED1.6 (A5), U2.2 (PD4)
/C6: LED1.11 (A6), U2.9 (PD5)
/C7: LED1.15 (A7), U2.10 (PD6)
/C8: LED1.16 (A8), U2.11 (PD7)
/E1: JP1.2, U2.23 (PC0)
/E2: JP1.3, U2.24 (PC1)
/E3: JP2.2, U2.25 (PC2)
/E4: JP2.3, U2.22 (PA1)
/R1: LED1.9 (K1), U2.12 (PB0)
/R2: LED1.14 (K2), U2.13 (PB1)
/R3: LED1.8 (K3), U2.14 (PB2)
/R4/MOSI: ISP1.4, LED1.12 (K4), U2.15 (PB3)
/R5/MISO: ISP1.1, LED1.1 (K5), U2.16 (PB4)
/R6/SCK: ISP1.3, LED1.7 (K6), U2.17 (PB5)
/R7/CLKI: J3.1, LED1.2 (K7), U2.7 (PB6)
/R8: LED1.5 (K8), U2.8 (PB7)
/RESET: ISP1.5, R4.1, U2.29 (~RESET/PC6)
/SCL: R5.2, U2.28 (PC5), U3.6 (SCL)
/SDA: R6.2, U2.27 (PC4), U3.5 (SDA)
/TRIG2: R2.2, U2.6 (PA3)
GND: BT1.2 (-), C2.2, C3.2, D1.1 (K), D2.2 (A), ISP1.6, J1.SLEEVE, JP1.4, JP2.4, R3.1, S1.3, S2.3, U2.5 (GND), U2.21 (GND), U3.1 (A0), U3.2 (A1), U3.3 (A2), U3.4 (GND), U3.7 (WP)
unnamed: C1.1, D1.2 (A), D2.1 (K), R1.1
unnamed: J1.RING, R1.2
VCC: BT1.1 (+), C3.1, ISP1.2, JP1.1, JP2.1, R4.2, R5.1, R6.1, U2.4 (VCC), U2.18 (AVCC), U3.8 (VCC)
