Sternenlabor/Blinkenstar/(commit log)

2025-03-28 ༼ つ ◕_◕ ༽つ in fairy dust we trust..
    [BOM.csv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]
2025-03-28 added 3D models
    [ATTINY88-AU.STEP, BH-642.STEP, Blinkenstar.kicad_pcb, M24C64-RMN6TP.STEP, PJ-307--3DModel-STEP-510211.STEP, TA08-81GWA--3DModel-STEP-510211.STEP]
2025-03-31 better ICSP layout
    [Blinkenstar.kicad_pcb]
2025-04-10 enhance pad size for MCU soldering
    [Blinkenstar.kicad_pcb]
2025-06-02 Change Display refresh rate to 60 Hz
2025-06-20 fix GND issue
    [Blinkenstar.kicad_pcb]
2025-08-28 Adds CLKI connector for clock input
    Adds a single-pin connector for external clock input (CLKI).
    This enables the Blinkenstar to synchronize with an external clock source.
    Also sets 'exclude_from_bom' and 'dnp' attributes to the test point components.
    [Blinkenstar.kicad_pcb, Blinkenstar.kicad_sch]
2025-08-28 Adds modem receiver and diagnostics
    Implements a receive-only audio modem with FEC. The modem
    demodulates audio input from the ADC, applies Hamming(24,16)
    forward error correction, and stores decoded bytes into flash
    memory via the existing Storage class.
    Adds simple diagnostics mode enabled by build flags, allowing
    testing of the display hardware by directly controlling
    columns via button presses.
    Updates static patterns to use a faster scroll speed.
    [main.cpp]
2026-04-03 feat: add audio output and sine wave generation functionality
    - Implemented audio output capabilities with the Speaker module.
    - Created functions for generating and playing sine wave PCM audio.
    - Added transfer tone encoding and playback features.
    - Developed tests for audio output, sine wave generation, and transfer tone encoding.
    - Ensured all scripts are in ES module format and removed legacy .js files.
    - Updated package.json to include new test scripts for audio functionalities.
    [Blinkenstar.kicad_pcb, Blinkenstar.kicad_sch, bom.csv, designators.csv]
2026-04-04 feat(modem): enhance ADC handling and diagnostics logging
    - Added static methods in Modem.h for ADC digital input mask and conversion start.
    - Implemented payload buffer display logic in Receiver.cpp for showing stored patterns.
    - Introduced diagnostic logging functionality in Receiver for tracking state transitions and events.
    - Updated System initialization to capture and log reset causes, with options for headless RX diagnostics.
    - Refactored platformio.ini to streamline build flags and ensure legacy modem configurations are used.
    - Added tests for modem ADC configurations, legacy demodulator behavior, receiver frame completion guards, and reset cause diagnostics.
    - Implemented EEPROM-bas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
2026-04-05 feat: implement full rename of legacy identifiers to blinkenstar
    - Added a comprehensive plan and design document for renaming all instances of `rocket` and `Blinkenrocket` to `blinkenstar` and `Blinkenstar` across firmware, documentation, and KiCad files.
    - Created regression tests to ensure the rename does not alter existing behavior.
    - Refactored firmware code to replace legacy identifiers with the new naming convention.
    - Updated KiCad library identifiers and local asset filenames to reflect the new naming.
    - Ensured all changes are covered by tests and verified through the existing build and test processes.
    refactor: separate TwiBus from Storage
    - Introduced a new `TwiBus` library to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
    [main.cpp]
2026-04-05 feat: rename legacy identifiers to blinkenstar and update related tests
    [Blinkenstar.kicad_sch]
2026-04-05 feat(display): add support for storage-backed animations with chunk loading
    - Introduced `startAnimation_` method to handle both regular and storage-backed animations.
    - Added `showFromStorage` method to initiate animations that can be loaded in chunks from EEPROM.
    - Implemented chunk loading logic in `ensureStorageChunkLoaded_` and `chunkOffset_` methods.
    - Updated `update` method to handle chunked data for both frame and text animations.
    - Modified `snapshotState` and `restoreState` to track and restore storage-backed animation state.
    - Adjusted `showPayloadBuffer` in `Receiver.cpp` to differentiate between regular and storage-backed animations.
    - Updated tests to verify the new chunk load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
2026-04-05 feat(buttons): implement button browse locking mechanism to prevent contact bounce
2026-04-07 Enhance transfer handling and debugging features
    - Update documentation to clarify behavior for stalled transfers and error handling.
    - Modify the board usage documentation to reflect timeout behavior for incomplete frames.
    - Improve firmware structure by adding timeout recovery for interrupted transfers in the modem receiver.
    - Refactor display logic to support animation rewind and repeat handling.
    - Implement debug logging conditionally based on configuration flags.
    - Introduce new tests to verify the correct handling of animation boundaries and interrupted transfer timeouts.
    - Optimize shutdown animation timing using a lookup table for frame delays.
2026-05-13 feat: Add Blinkenstar hardware and comprehensive documentation
    - Integrate the Blinkenstar hardware design files, including KiCad project data and related assets.
    - Introduce two versions of the buildable Blinkenstar manual in Markdown format.
    - Implement a Node.js-based script for generating PDF manuals from Markdown, complete with image and text reflow capabilities.
    - Update the project's licensing to a granular structure, specifying licenses for hardware (CERN-OHL-1.2), firmware (LGPL-3.0-only), documentation (CC-BY-SA-4.0), and host utilities (MIT).
    - Update the README to reflect the new licensing overview.
2026-05-13 feat: Add PCB Styler project archive
2026-05-14 feat: Refine system interaction and modem reliability
    - Invert stored pattern navigation button logic for improved user experience.
    - Implement a two-button chord for waking from deep sleep, preventing accidental wake-ups.
    - Ensure the FEC modem's state is cleared on initialization and report buffered decoded bytes immediately.
    - Restart the modem receiver after ADC power is restored during system wake-up.
    - Update KiCad project files and revise silkscreen elements for the latest hardware revision.
    [Blinkenstar.kicad_pcb]
2026-05-14 Update Blinkenstar configuration and production files
    - Added "OPEN BROWSER" and "NO_BACKUP_OPT" options to fabrication-toolkit-options.json.
    - Introduced new production zip file Blinkenstar_2.9.zip.
    - Created backup zip file Blinkenstar_2.9_2026-05-14_22-12-31.zip.
    - Modified netlist.ipc to update VIA connections, replacing several with new identifiers and removing obsolete entries.
    - Adjusted J1 connections in netlist.ipc for improved clarity and accuracy.
    [Blinkenstar.kicad_pcb, Blinkenstar.kicad_sch]
